FBIopeningUPP/corne-lp-handwired/out/bases_underneath.png

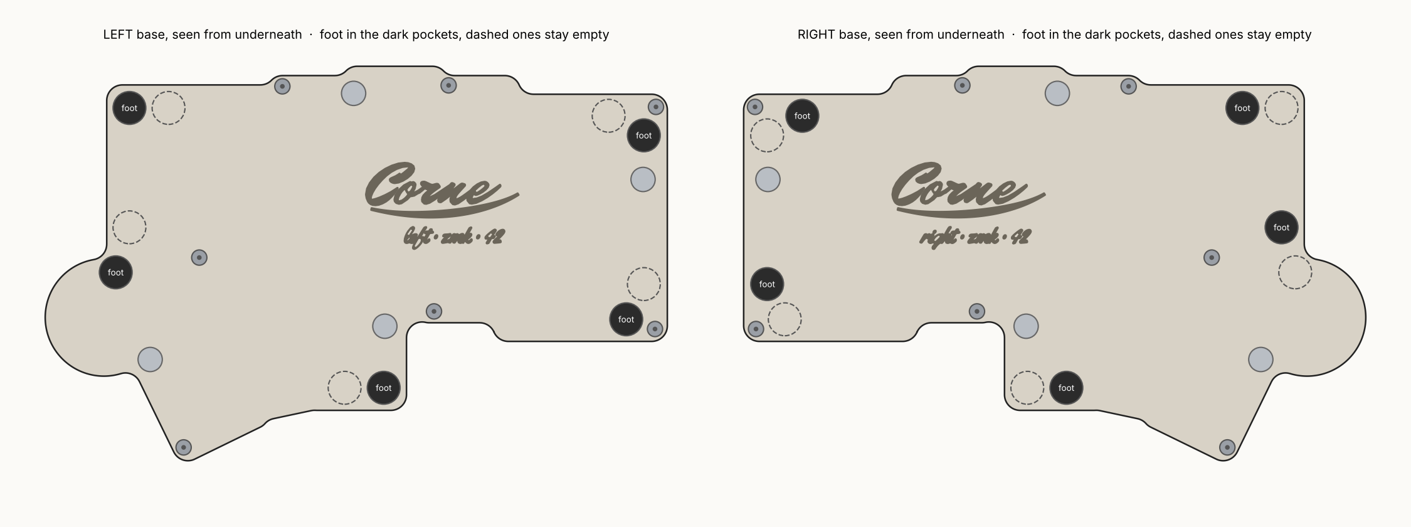
out/bases_underneath.png
