FBIopeningUPP/corne-lp-handwired/out/in_use.png

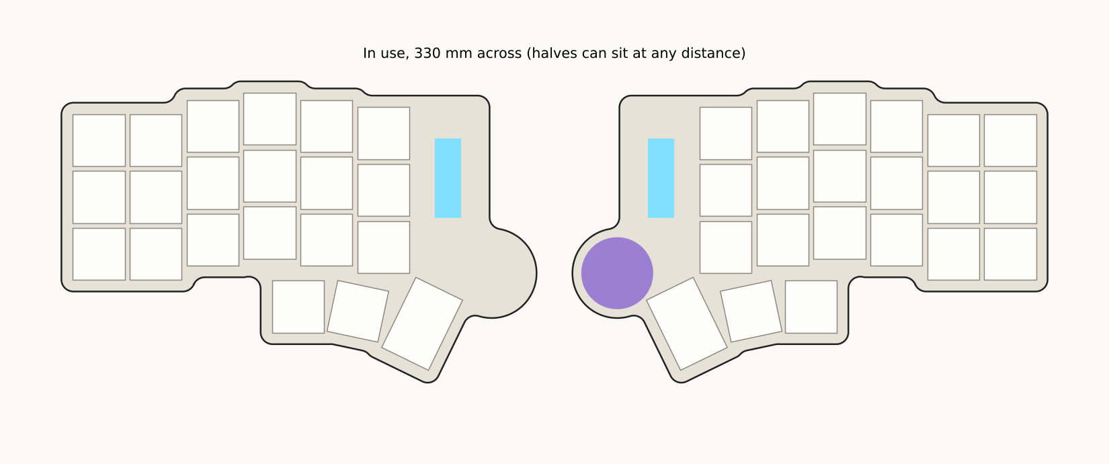
out/in_use.png
