FBIopeningUPP/corne-lp-handwired/out/oled_preview.gif

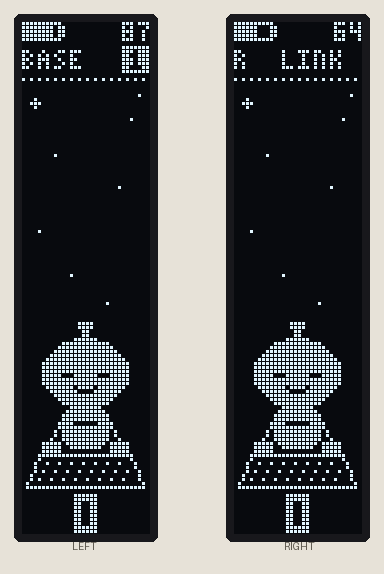
out/oled_preview.gif
