FBIopeningUPP/corne-lp-handwired/out/renders/01_hero.png

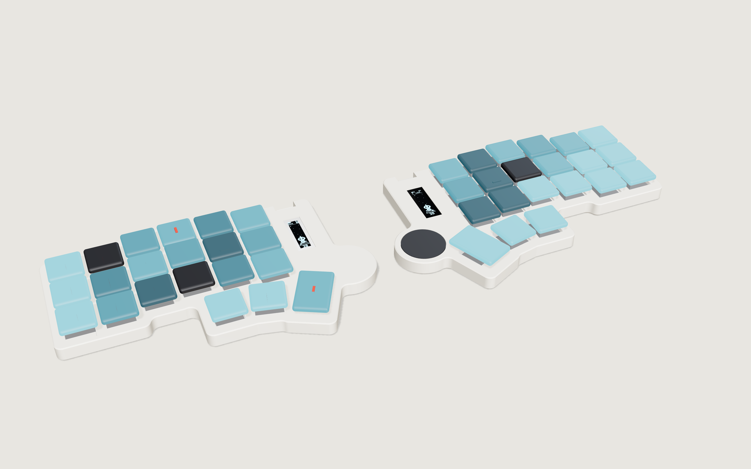
out/renders/01_hero.png
