FBIopeningUPP/corne-lp-handwired/out/style_options/case_styles.png

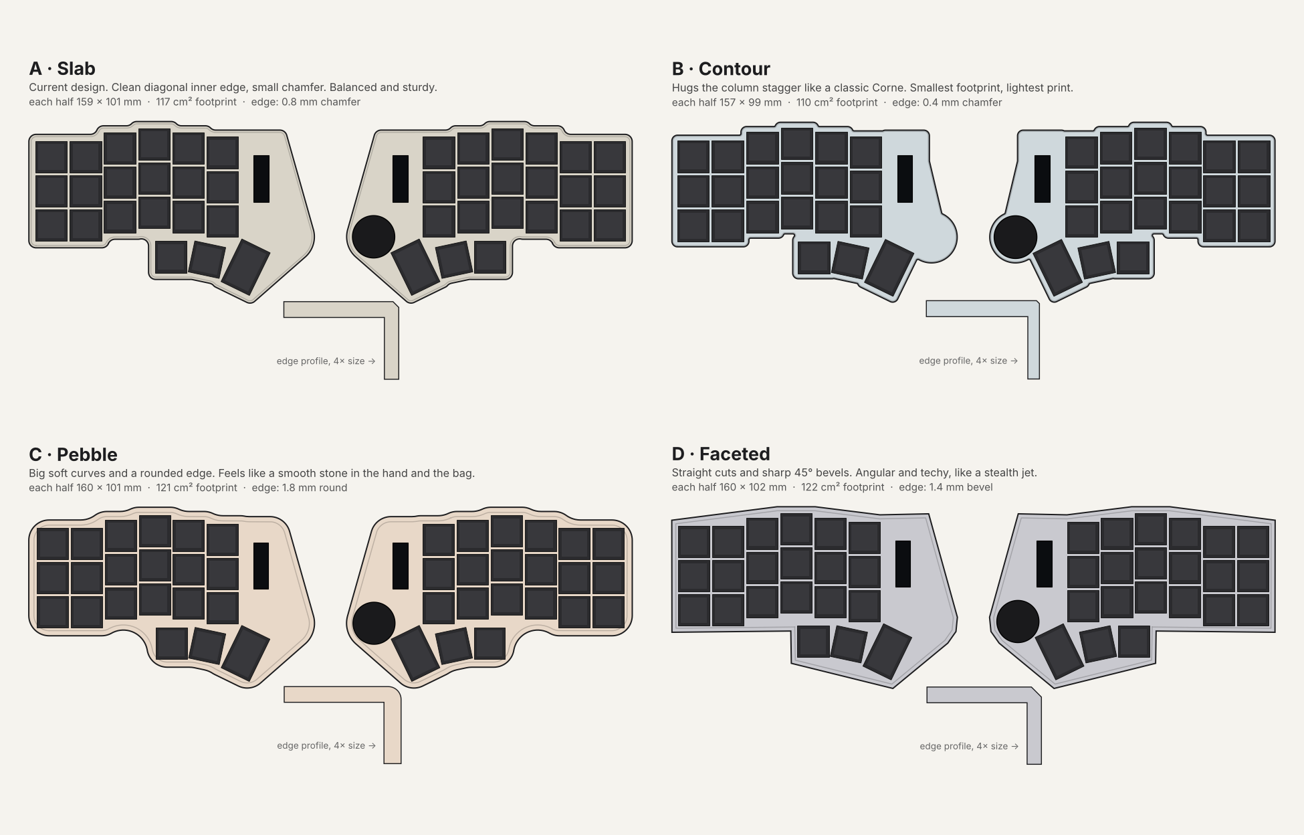
out/style_options/case_styles.png
