FBIopeningUPP/corne-lp-handwired/out/style_options/case_styles_simple.png

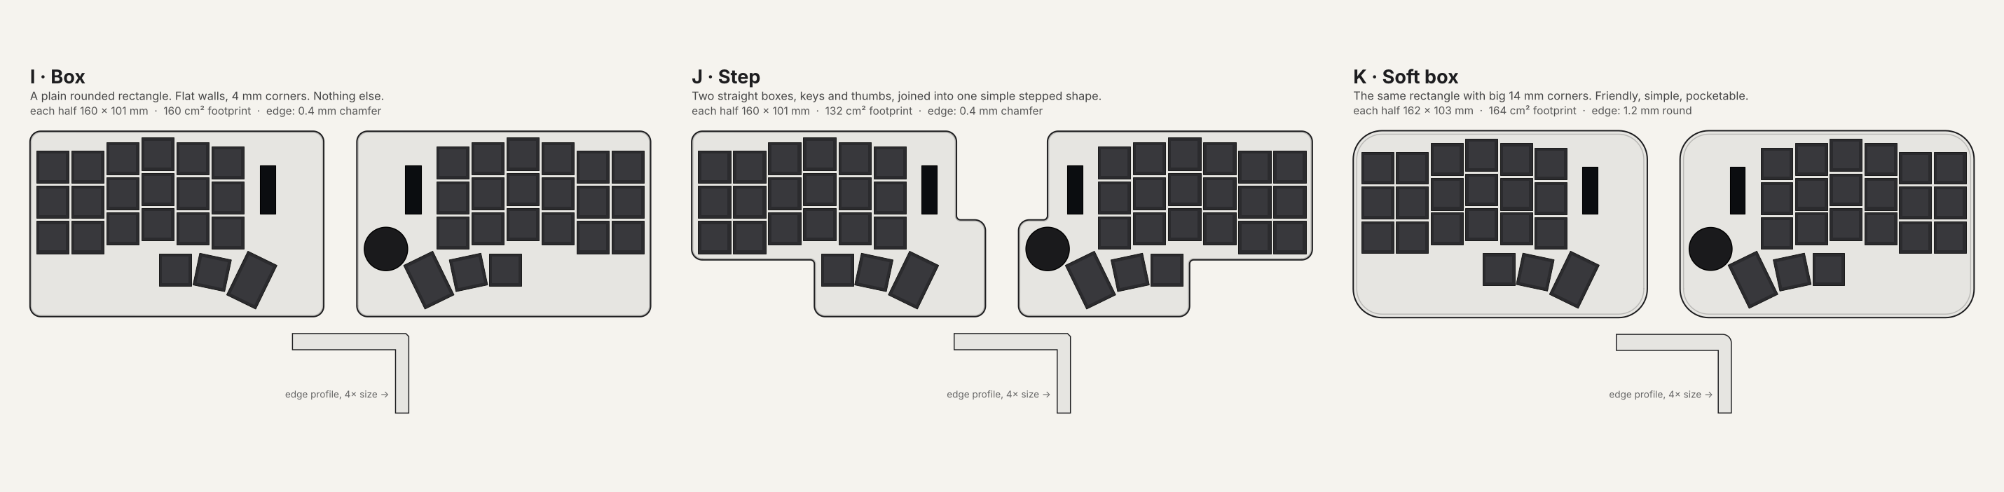
out/style_options/case_styles_simple.png
