FBIopeningUPP/corne-lp-handwired/out/supermini_pinout.png

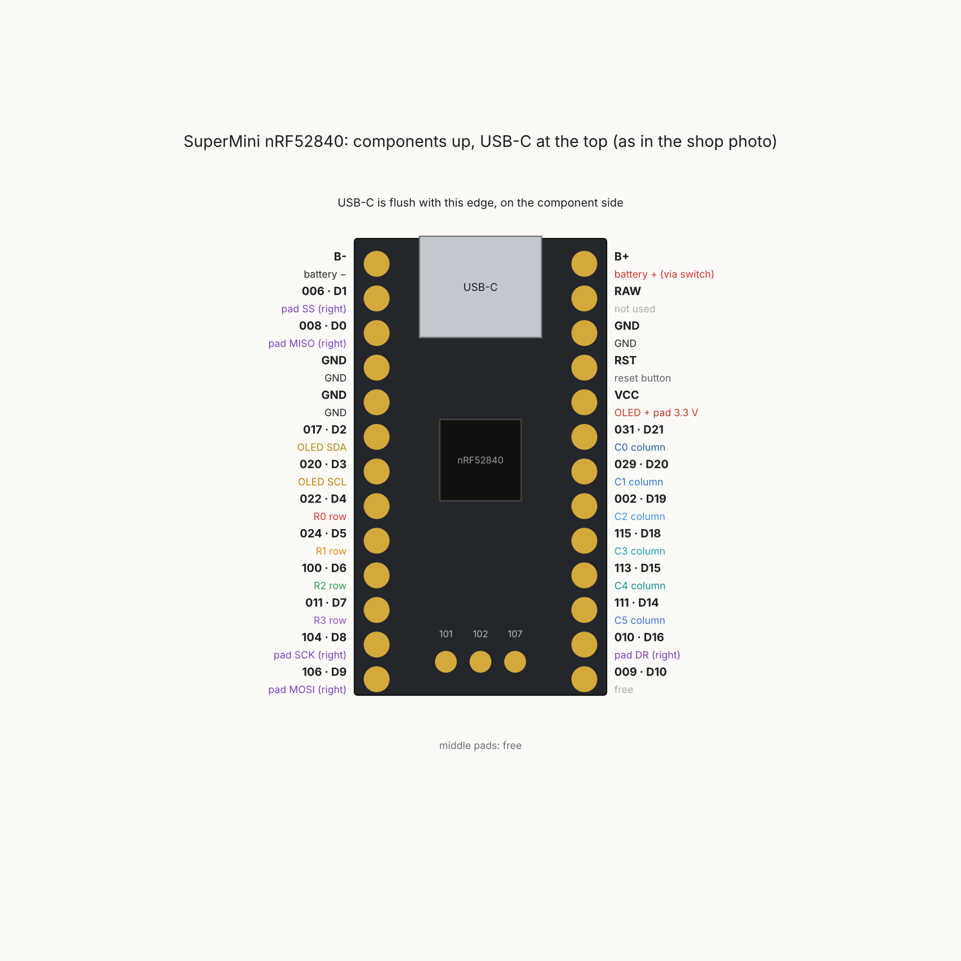
out/supermini_pinout.png
