FBIopeningUPP/corne-lp-handwired/out/top_view.png

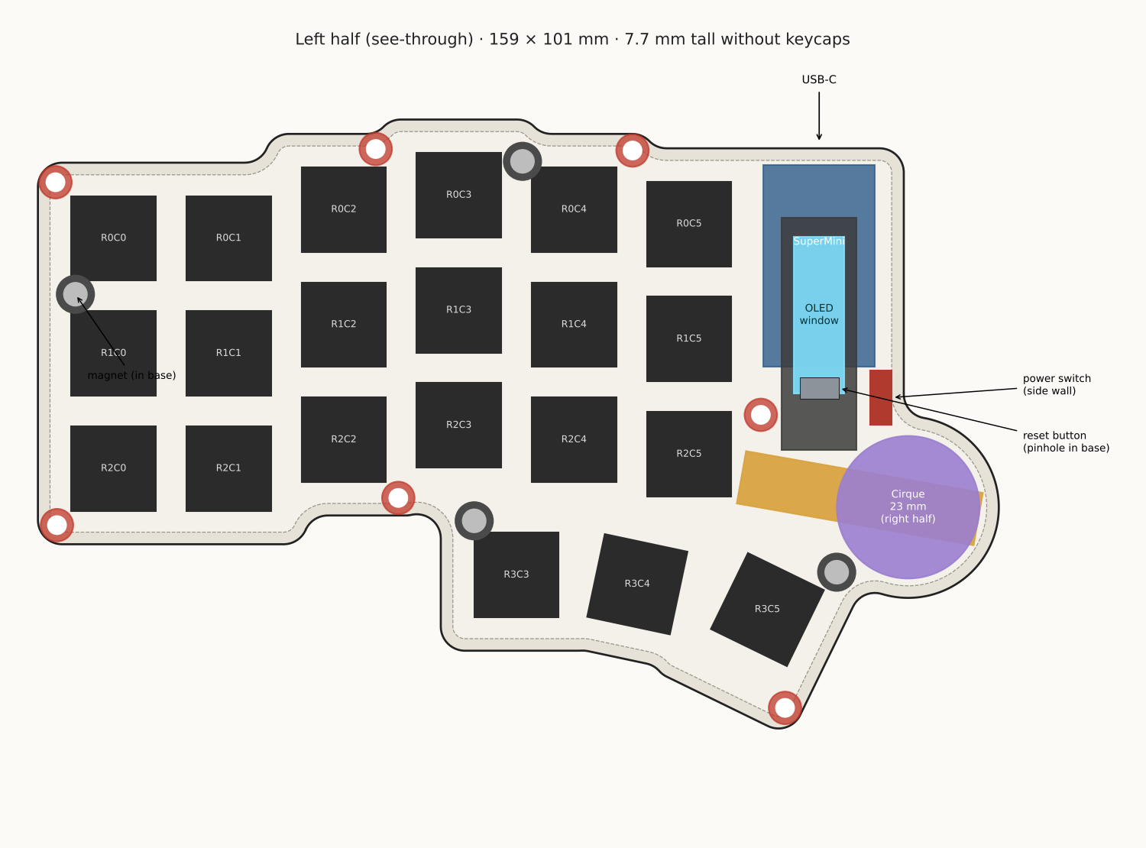
out/top_view.png
