FBIopeningUPP/corne-lp-handwired/keycaps/clp_ks33/saddle.stl

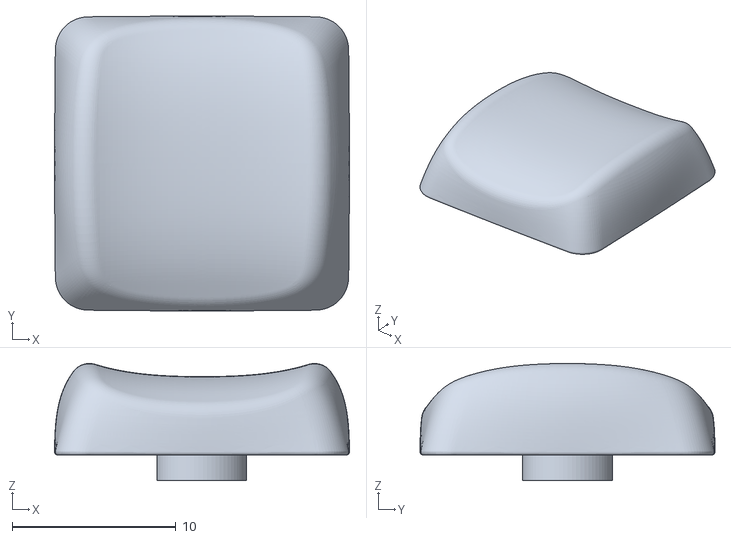
[picture p16: CAD file, 2026-10-18]
keycaps/clp_ks33/saddle.stl
18.0 x 18.0 x 7.14
