FBIopeningUPP/corne-lp-handwired/out/bumper_bottom.stl

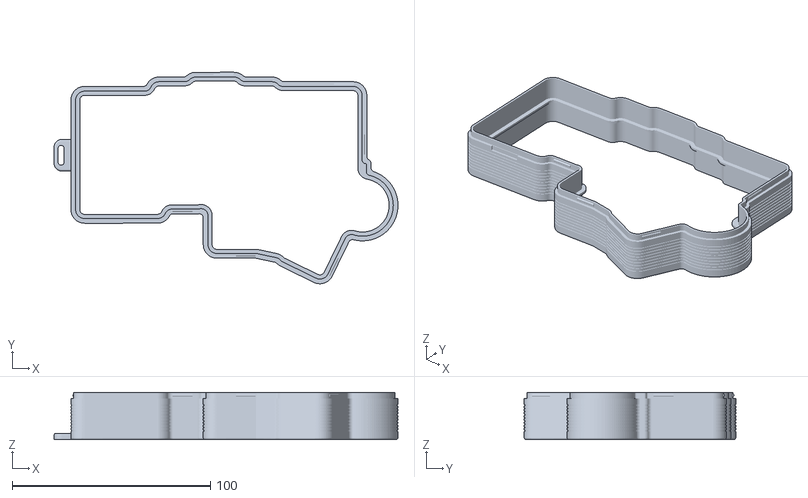
[picture p17: CAD file, 2026-10-18]
out/bumper_bottom.stl
173.3 x 106.6 x 23.8
