FBIopeningUPP/corne-lp-handwired/out/test_kit/1_switch_strip.stl

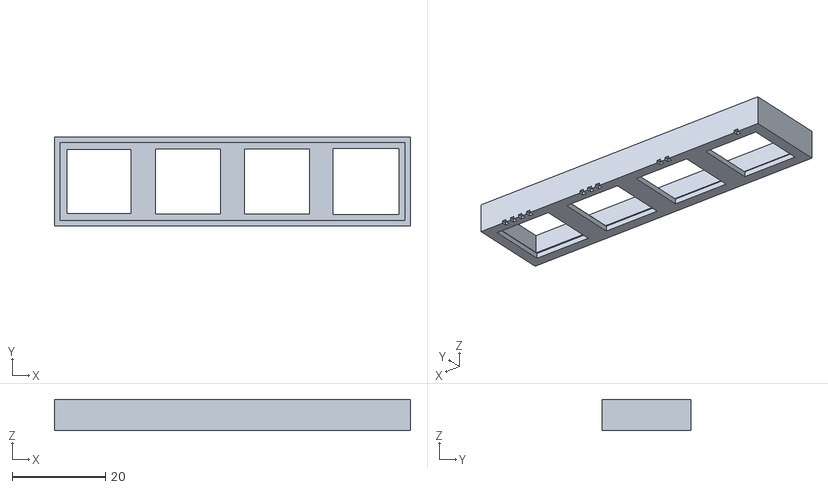
[picture p18: CAD file, 2026-10-18]
out/test_kit/1_switch_strip.stl
76.2 x 19.0 x 6.70
