FBIopeningUPP/corne-lp-handwired/print/carry-case/carry_tray.stl

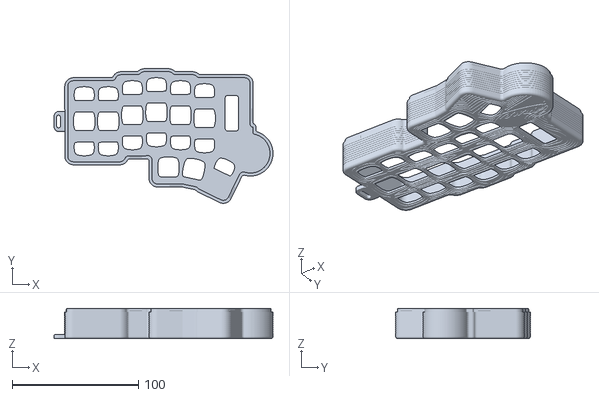
[picture p19: CAD file, 2026-10-18]
print/carry-case/carry_tray.stl
173.3 x 106.6 x 23.8
