FBIopeningUPP/corne-lp-handwired/print/test-kit/3_clp_saddle_cap.stl

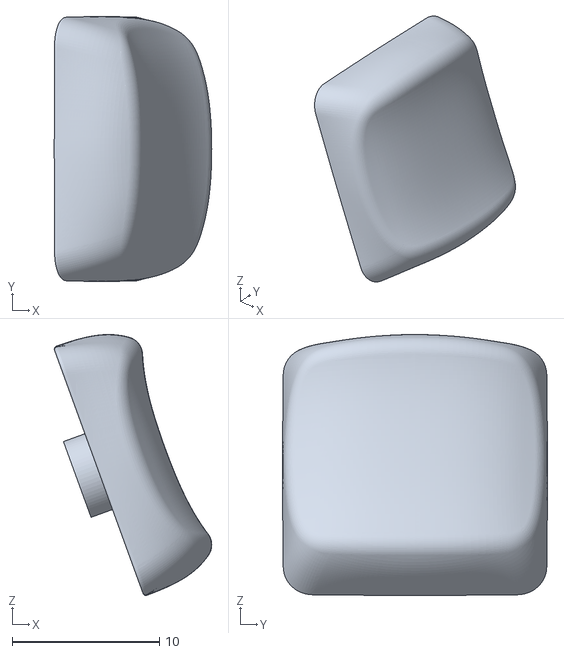
[picture p20: CAD file, 2026-10-18]
print/test-kit/3_clp_saddle_cap.stl
10.7 x 18.0 x 17.7
