FBIopeningUPP/corne-lp-handwired/cad/shell_left.step

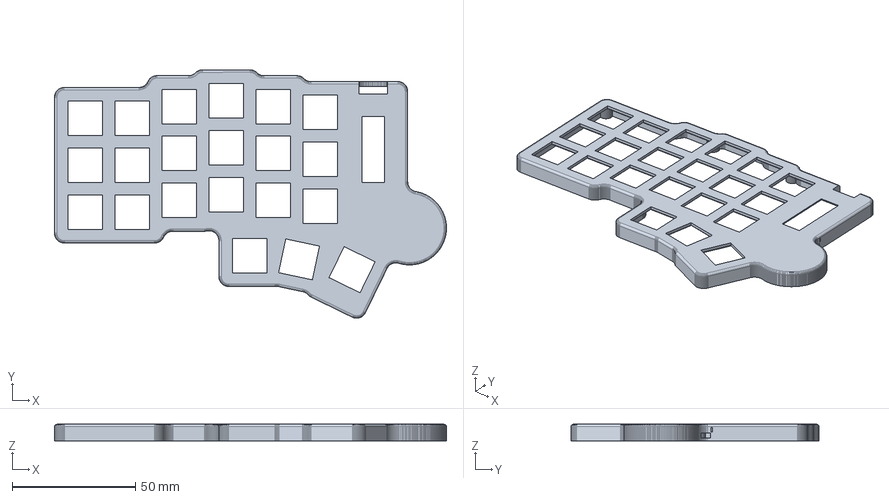
[picture p21: CAD file, 2026-10-18]
cad/shell_left.step
159.0 x 100.8 x 6.70 mm
