FBIopeningUPP/corne-lp-handwired/keycaps/clp_ks33/thumb.stl

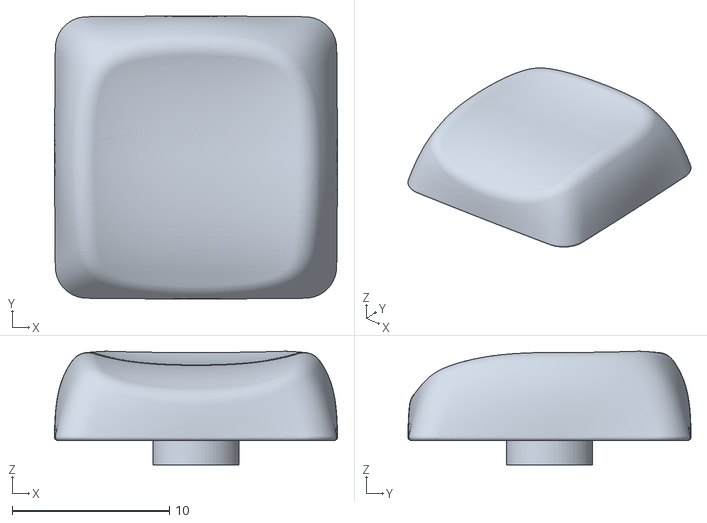
[picture p22: CAD file, 2026-10-18]
keycaps/clp_ks33/thumb.stl
18.0 x 18.0 x 7.22
