FBIopeningUPP/corne-lp-handwired/out/bottom_left.stl

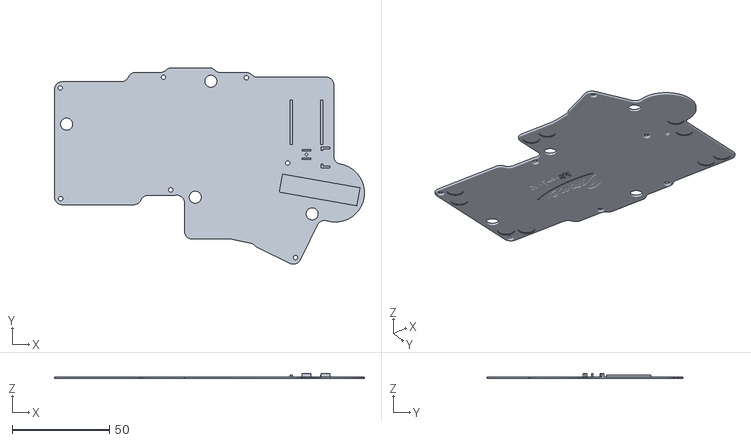
[picture p23: CAD file, 2026-10-18]
out/bottom_left.stl
159.0 x 100.8 x 2.80
