FBIopeningUPP/corne-lp-handwired/print/test-kit/test_kit.3mf

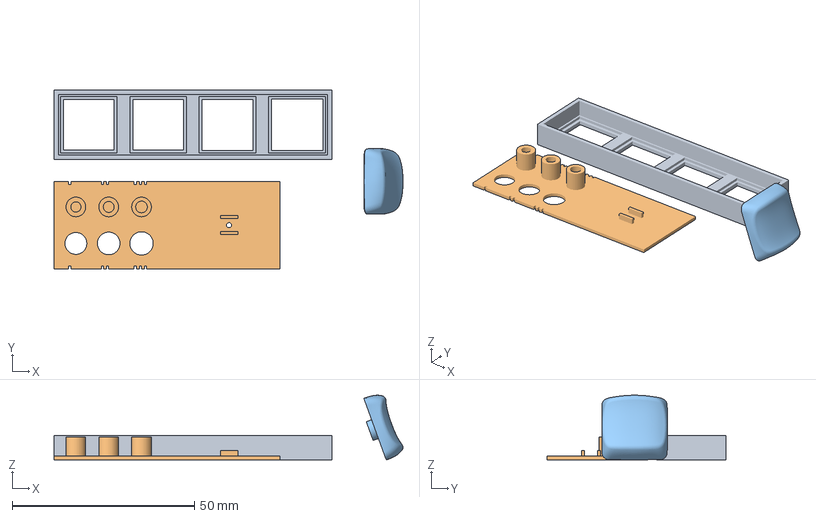
[picture p24: CAD file, 2026-10-18]
print/test-kit/test_kit.3mf
95.7 x 49.1 x 17.7 mm
Switch fit strip (13.8-14.1)
Coupon: magnets / inserts / reset
CLP Saddle cap
