FBIopeningUPP/corne-lp-handwired/keycaps/clp_ks33/tilt7.stl

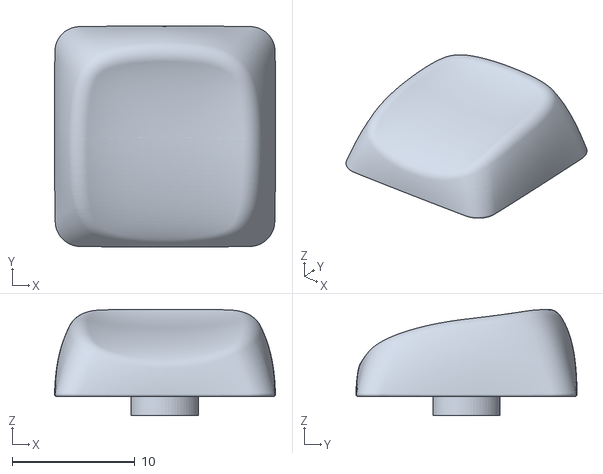
[picture p25: CAD file, 2026-10-18]
keycaps/clp_ks33/tilt7.stl
18.0 x 18.0 x 8.66
