FBIopeningUPP/corne-lp-handwired/out/bumper_top.stl

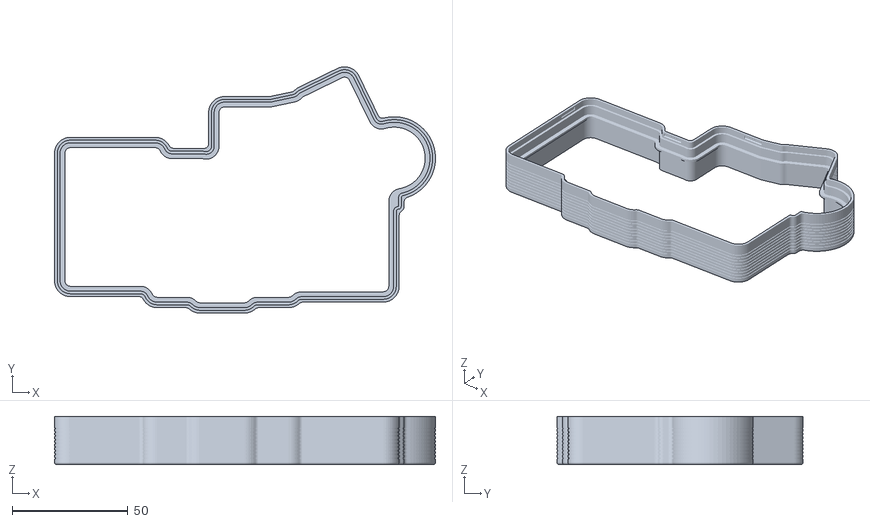
[picture p26: CAD file, 2026-10-18]
out/bumper_top.stl
164.8 x 106.6 x 20.8
