FBIopeningUPP/corne-lp-handwired/out/carry_lid.stl

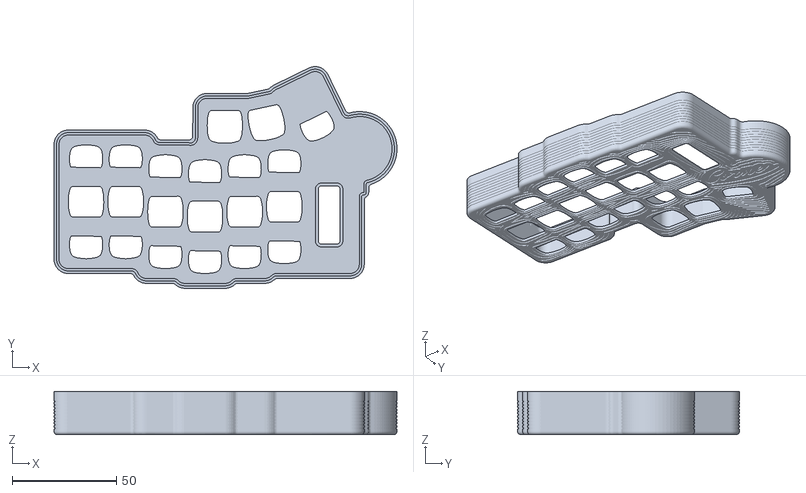
[picture p27: CAD file, 2026-10-18]
out/carry_lid.stl
164.8 x 106.6 x 20.8
