FBIopeningUPP/corne-lp-handwired/keycaps/clp_ks33/tilt7_1u5.stl

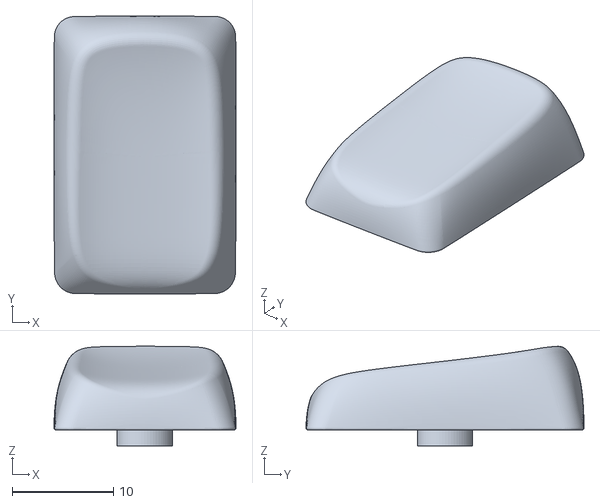
[picture p28: CAD file, 2026-10-18]
keycaps/clp_ks33/tilt7_1u5.stl
18.0 x 27.5 x 9.85
