FBIopeningUPP/corne-lp-handwired/(list of files, cad)

Other CAD files:
print/keyboard/shell_right.stl
print/keyboard/shell_left.stl
cad/bottom_right.step
keycaps/clp_ks33/saddle_homing.stl
out/bottom_right.stl
