FBIopeningUPP/corne-lp-handwired/out/wiring_matrix.png

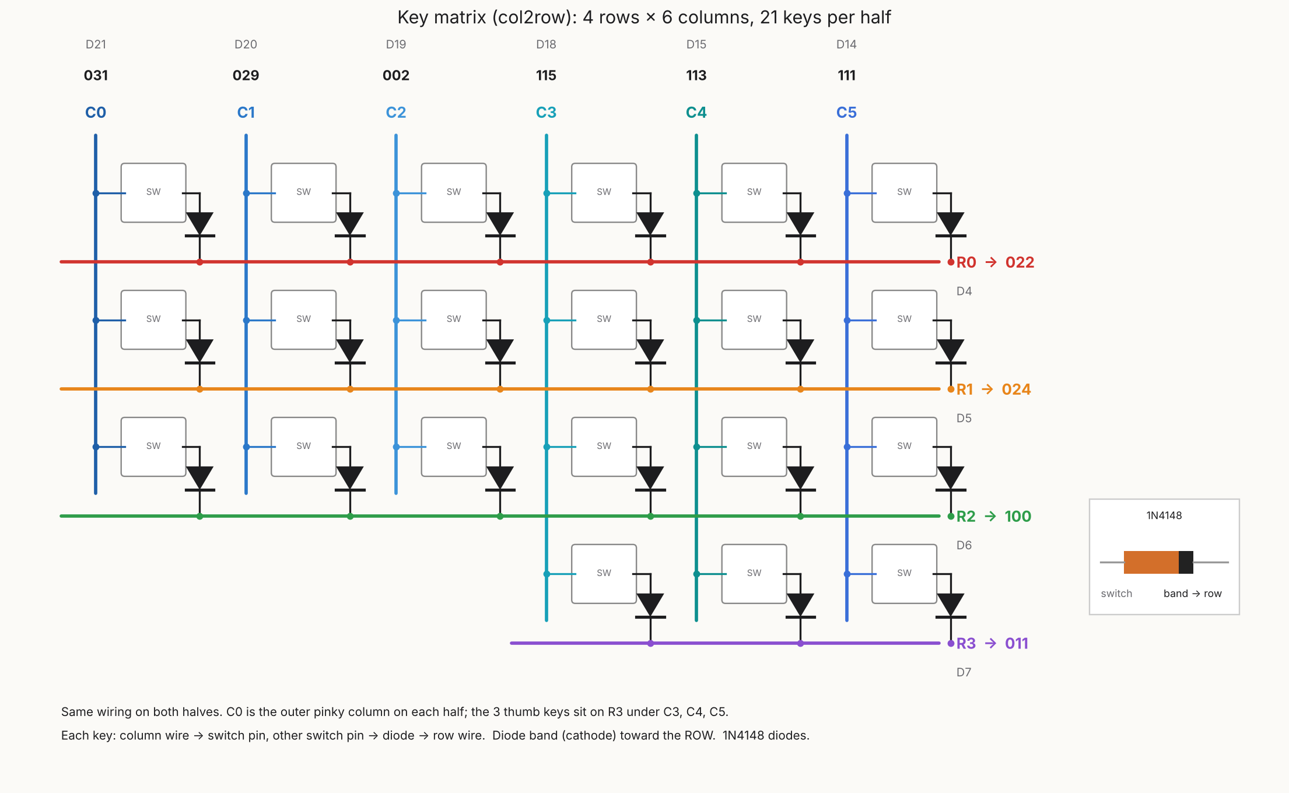
out/wiring_matrix.png
