FBIopeningUPP/corne-lp-handwired/out/wiring_guide.pdf

C0

031

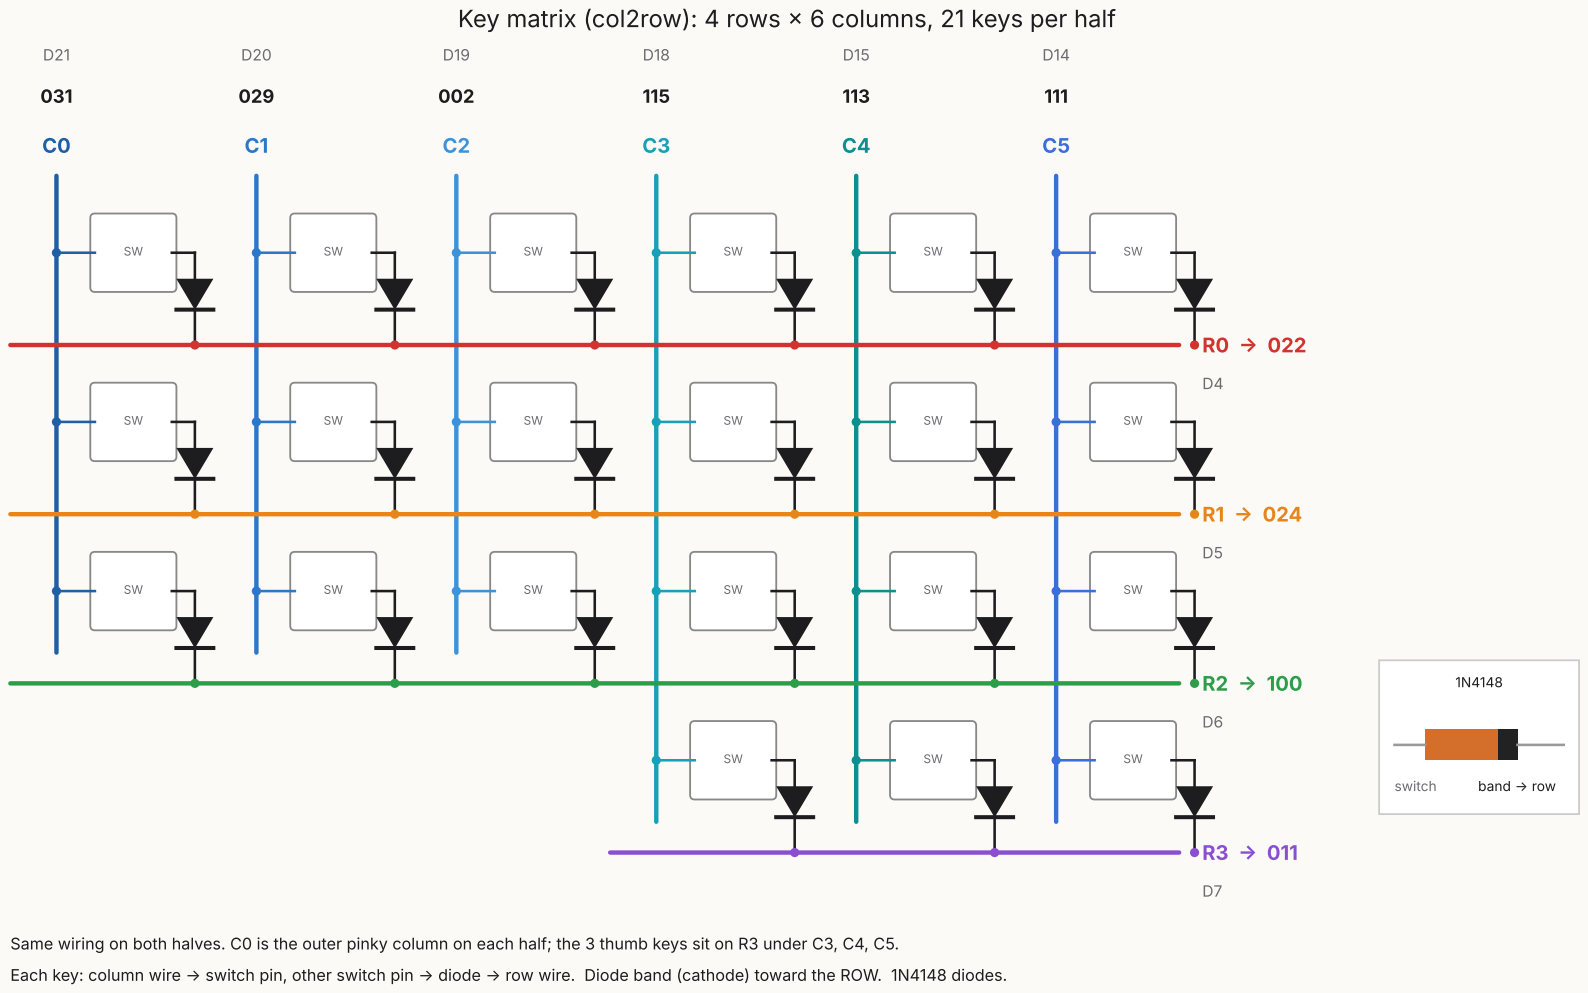
[picture p30: page 1]

Key matrix (col2row): 4 rows × 6 columns, 21 keys per half

Same wiring on both halves. C0 is the outer pinky column on each half; the 3 thumb keys sit on R3 under C3, C4, C5.
Each key: column wire → switch pin, other switch pin → diode → row wire. Diode band (cathode) toward the ROW. 1N4148 diodes.

# LEFT half: complete wiring, seen from underneath

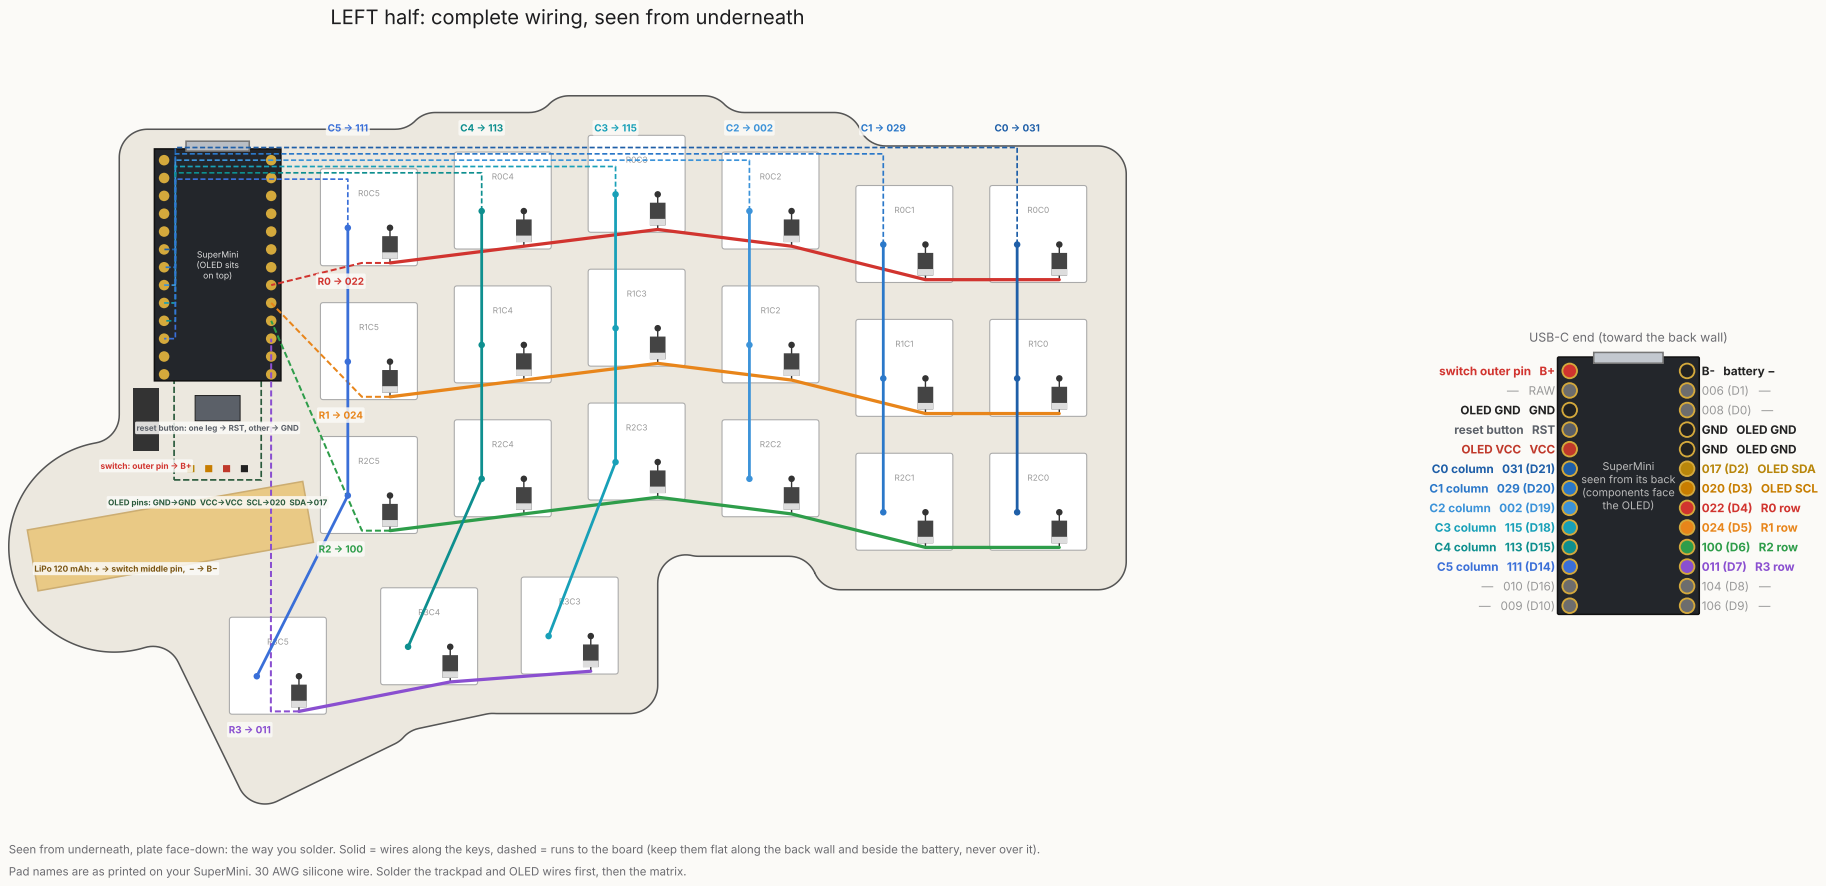
[picture p31: page 2]

SuperMini (OLED sits

on top) | R0 → 022

USB-C end (toward the back wall)

reset button: one leg → RST, other → GND

SuperMini
seen from its back
(components face
the OLED)

OLED pins: GND→GND VCC→VCC SCL→020 SDA→017

LiPo 120 mAh: + → switch middle pin, − → B−

Seen from underneath, plate face-down: the way you solder. Solid = wires along the keys, dashed = runs to the board (keep them flat along the back wall and beside the battery, never over it).

Pad names are as printed on your SuperMini. 30 AWG silicone wire. Solder the trackpad and OLED wires first, then the matrix.

# RIGHT half: complete wiring, seen from underneath

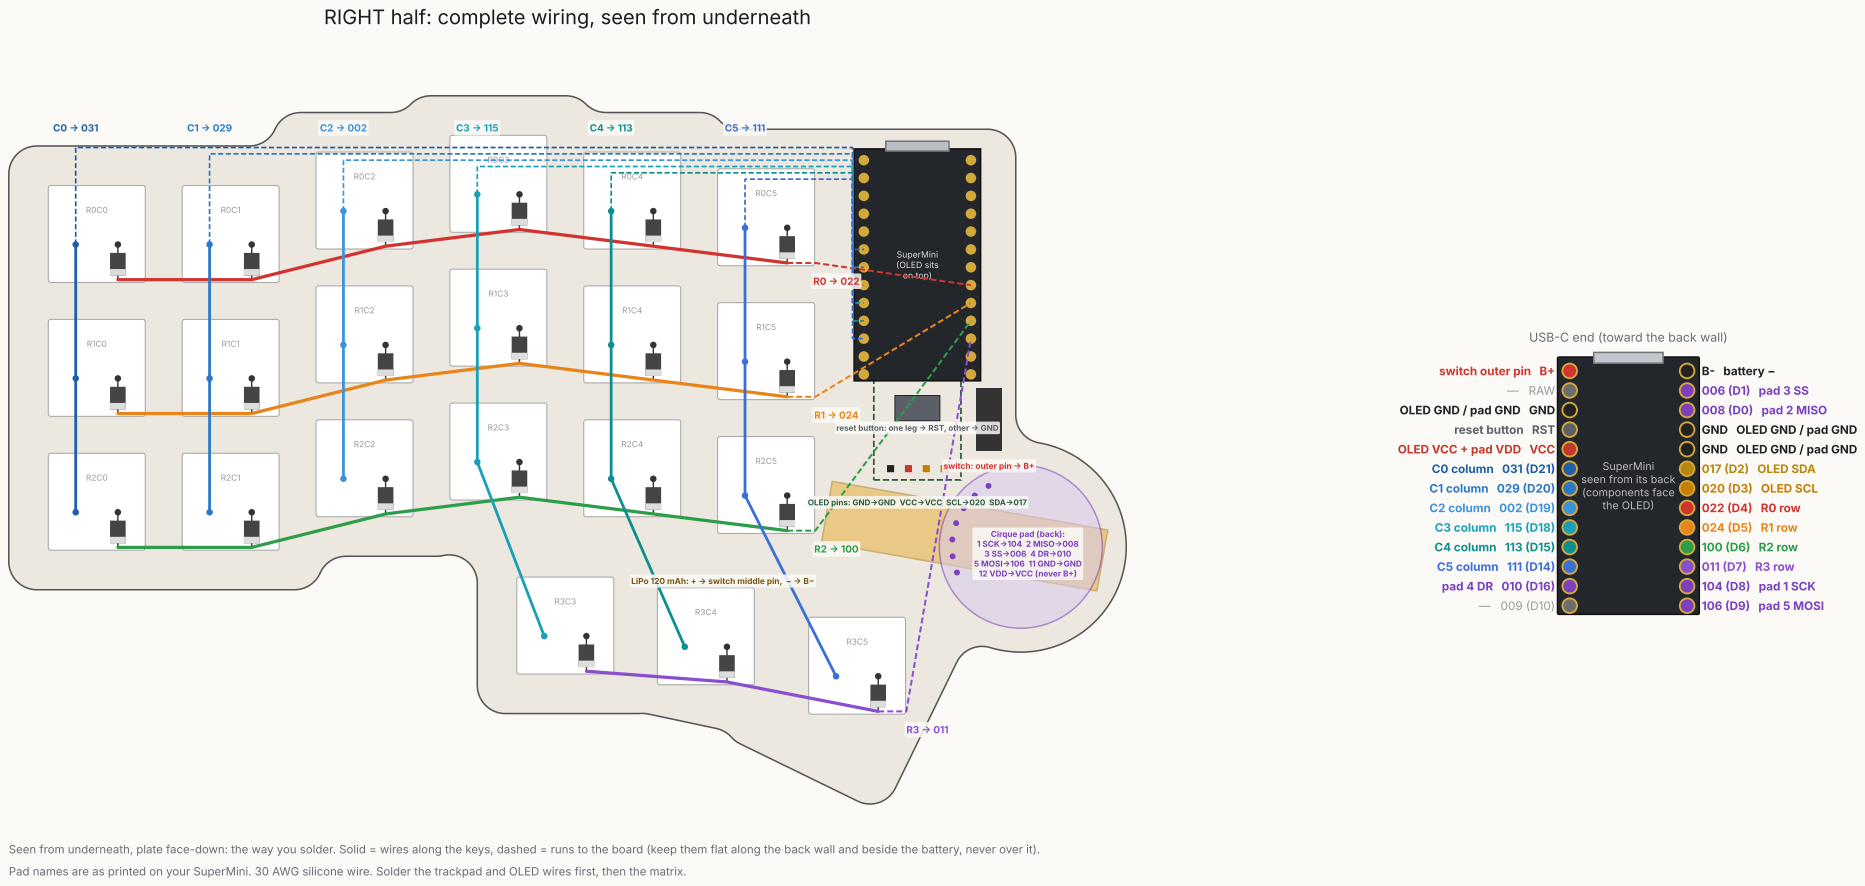
[picture p32: page 3]

USB-C end (toward the back wall)

006 (D1) pad 3 SS
008 (D0) pad 2 MISO
GND OLED GND / pad GND
017 (D2) OLED SDA
020 (D3) OLED SCL
022 (D4) R0 row
024 (D5) R1 row
100 (D6) R2 row
011 (D7) R3 row
104 (D8) pad 1 SCK
106 (D9) pad 5 MOSI

reset button: one leg → RST, other → GND

OLED GND / pad GND GND

OLED VCC + pad VDD VCC

SuperMini
seen from its back
(components face
the OLED)

OLED pins: GND→GND VCC→VCC SCL→020 SDA→017

LiPo 120 mAh: + → switch middle pin, − → B−

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

## SuperMini nRF52840: components up, USB-C at the top (as in the shop photo)

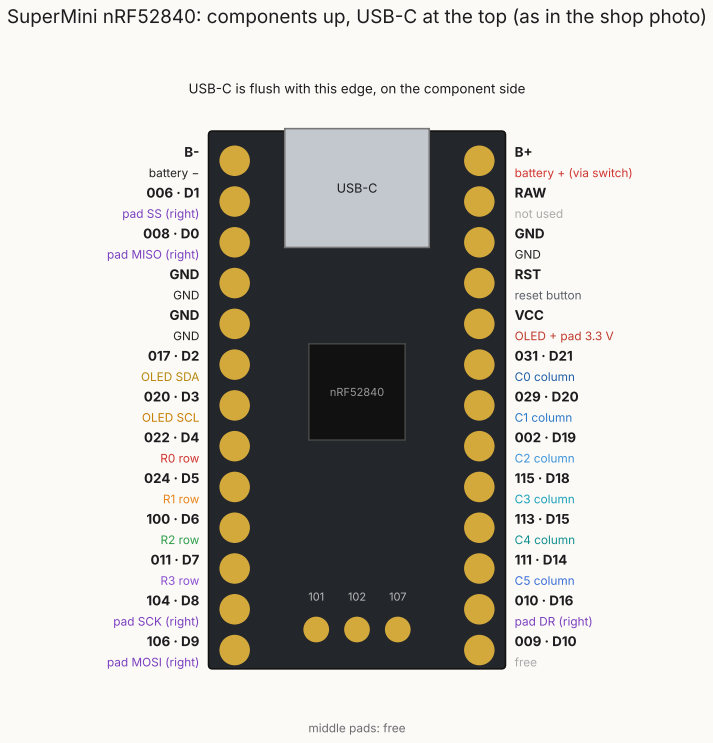
[picture p33: page 4]

USB-C is flush with this edge, on the component side
