FBIopeningUPP/corne-lp-handwired/(commit log)

2026-10-18 Corne LP: handwired wireless low-profile split keyboard
    Case generator (Python CAD), printable STLs, test kit, carry case and bumper,
    ZMK config + prebuilt firmware, wiring guide, 3D viewer and README.
    Claude-Session: https://claude.ai/code/session_01DgBTMTPM1Y7w1v6derLfvG
2026-10-18 STEP solids: shells, bases, fit test; carry case + bumper zipped
    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
2026-10-18 CLP keycaps: stock models, KS-33 versions (2.1 mm longer stem), Orca print plate
    CLP keycaps by vvhg1 (GPL v3, license included).
    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
2026-10-18 Reorganize repo and rewrite README as a showcase
    - print/ holds everything you slice (keyboard, keycaps, carry case, test kit),
    cad/ the STEP solids, docs/ the build guide, wiring PDF, renders and drawings
    - generator scripts write to the new folders (paths live in case/case.py)
    - README is now a showcase with studio renders; the full instructions moved
    to docs/build-guide.md with diagrams next to the steps they explain
    - tools/render drives the 3D viewer in headless Chromium to make the renders
    - fix stale case.py notes (1 mm base, 6 x 1 mm magnets, insert screws) and add
    networkx/scipy to case/requirements.txt (trimesh needs them for testkit.py)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
2026-10-18 README: banner, stats strip, keymap diagram and the full render set
    - banner and stats strip composed from the hero render (tools/render/compose.py)
    - keymap.svg drawn to scale from the real layout and corne_lp.keymap (tools/render/keymap.py)
    - top, close-up, exploded, x-ray, carry case, bumper renders and the colourway sheet
    - repo map folded into a collapsible section
    Claude-Session: https://claude.ai/code/session_013kBVs1p4zannwojJUm4ZKz
2026-10-23 Add a GitHub Pages site: landing page, 3D viewer, build guide, downloads
    - site/index.html: landing page with the renders, keymap, Blip and build steps
    - site/build.py: assembles _site/ (images, viewer, build guide as a web page,
    wiring PDF, zip of print/)
    - .github/workflows/pages.yml: builds and deploys on pushes to main
    - README links to the live site and viewer
    - keymap: shorten the Caps Word legend so it no longer collides with Mute
    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
